gavinmcc/esp8266-fan-remote/SPEC.md

# Protocol Specifications

Two fans are supported. Both use 13-pulse position-encoded OOK frames through the same CC1101.
The CC1101 frequency is switched per-command; PLL re-calibrates on SFSTXON.

---

# Fan 1 — Bedroom: RHINE UC7070T

## RF Parameters

| Parameter | Value |
|---|---|
| Frequency | 303.92 MHz  |
| Modulation  | OOK / ASK |
| Encoding | Position-encoded symbol pairs |

## Symbol Alphabet

Two pulse widths for each phase:

| Name | Phase | Width (µs) | Measured range |
|---|---|---|---|
| SHORT_H | HIGH  | ~250 | 195–296 µs |
| LONG_H  | HIGH  | ~550 | 400–662 µs |
| SHORT_L | LOW | ~450 | 294–499 µs |
| LONG_L  | LOW | ~790 | 743–848 µs |
| GAP | LOW | ~8000 | inter-rep gap  |

Each pulse is a (HIGH, LOW) pair. Symbol names use two letters: first = HIGH class, second = LOW class.

| Symbol | HIGH phase | LOW phase |
|---|---|---|
| LS | LONG_H | SHORT_L  |
| LL | LONG_H | LONG_L |
| SL | SHORT_H | LONG_L |
| SS | SHORT_H | SHORT_L  |

## Packet Structure

Each button press transmits **4 repetitions** of the following 13-pulse frame, each followed by an 8 ms gap:

```
[Header: 6 pulses] [Data: 7 pulses] [GAP 8ms]   × 4
```

### Header (6 pulses, fixed for all commands)

```
LS  LS  LL  SL  SS  LL
```

### Data Section (7 pulses, command-dependent)

The command is encoded by **N** — the position (0-indexed) of the `SS` symbol within the 7-pulse data section:

```
SL × N,  SS,  (tail)
```

**Tail when N < 5:**
```
LL,  SL × (4−N),  SHORT_H (terminal pulse before gap)
```

**Tail when N = 5:**
```
LONG_H (terminal pulse before gap)
```

All 5 valid N values produce identical total bit counts per rep (838 bits at 40 kbaud).

### Command Map

| Button | N | Data section (7 pulses) |
|---|---|---|
| HI | 0 | SS LL SL SL SL SL S_term |
| MED | 1 | SL SS LL SL SL SL S_term |
| LOW | 2 | SL SL SS LL SL SL S_term |
| OFF | 4 | SL SL SL SL SS LL S_term |
| LIGHT  | 5 | SL SL SL SL SL SS L_term |

N=3 not observed (may be unused or reserved).

## Capture Evidence

Re-captured with a dedicated second ESP8266+CC1101 RX unit. Each button pressed
individually; N value decoded from multiple clean 13-pulse frames per button.

| Button | N decoded | Notes |
|---|---|---|
| HI | 0 | SS at data[0], LL+SL×4 tail |
| MED | 1 | SS at data[1], LL+SL×3 tail |
| LOW | 2 | SS at data[2], LL+SL×2 tail |
| OFF | 4 | SS at data[4], LL+SL×0 tail |
| LIGHT  | 5 | SS at data[5], LONG_H tail |

Earlier 12-capture set (physical remote captured without dedicated RX unit) had
HI/MED swapped and LOW/LIGHT swapped in the label column — the N decoding logic
was correct but the buttons were mislabelled. OFF (N=4) was correct in both sets.

## Hardware

- **CC1101 module**: E07-M1010 (Ebyte/CDEBYTE) — 300–348 MHz, 10 dBm max TX
- **MCU**: ESP8266 (Generic / Wemos D1 Mini)

## CC1101 Configuration

TX uses CC1101 FIFO mode. The OOK pulse pattern is pre-computed as an NRZ byte stream at 40 kbaud (25 µs/bit) and streamed through the CC1101 TX FIFO.

| Register | Value | Purpose |
|---|---|---|
| PKTCTRL0 | `0x02` | FIFO mode, infinite packet length, no CRC, no whitening |
| MDMCFG2 | `0x30` | OOK modulation, no sync word |
| FREND0 | `0x11` | OOK=1 uses PATABLE[1] (carrier on); OOK=0 = PATABLE[0] (PA off) |
| DRATE | 40 kbaud | via `setDRate(40)` |
| PATABLE[0] | `0x00` | OOK=0 state — PA off (carrier silence) |
| PATABLE[1] | `0xC0` | OOK=1 state — ~10 dBm TX power |

**Critical PATABLE note:** `PATABLE[0]` must be `0x00`, not the library default `0xC0`.
If all 8 PATABLE entries are `0xC0`, OOK=0 still drives full carrier and no modulation
reaches the fan. The firmware writes this explicitly after library init:

```cpp
ELECHOUSE_cc1101.SpiWriteReg(REG_FREND0, 0x11);
byte pa[8]; memset(pa, 0x00, sizeof(pa)); pa[1] = 0xC0;
ELECHOUSE_cc1101.SpiWriteBurstReg(REG_PATABLE, pa, 8);
```

## FIFO Encoding (40 kbaud NRZ)

At 40 kbaud, 1 bit = 25 µs. Each OOK pulse phase is a run of 1-bits (carrier on) or 0-bits (carrier off).

| Symbol  | ON bits | OFF bits | Actual µs  | Target µs |
|---|---|---|---|---|
| SHORT_H | 10 | — | 250 | ~250 |
| LONG_H  | 22 | — | 550 | ~550 |
| SHORT_L | — | 18 | 450 | ~450 |
| LONG_L  | — | 32 | 800 | ~790 |
| GAP | — | 320 | 8000 | ~8000 |

Each rep is 838 bits. The firmware sends more reps than the original remote to improve reliability:

| Command | REPS | Total bits | Duration |
|---|---|---|---|
| HI | 25 | 20,950 | ~525 ms |
| MED | 25 | 20,950 | ~525 ms |
| LOW | 25 | 20,950 | ~525 ms |
| OFF | 50 | 41,900 | ~1050 ms |
| LIGHT | 10 | 8,380 | ~210 ms |

OFF uses more reps for reliability. LIGHT was originally set to 4 reps on the assumption
that more would trigger the dimmer, but 10 reps works reliably without dimming on the
tested unit. The dimmer threshold may be higher than initially estimated, or unit-dependent.

## TX Sequence

1. `buildStream(N)` — pre-compute NRZ byte stream into `g_stream[]`
2. `SFSTXON` strobe — PLL calibrates and locks (~800 µs), PA stays off (FSTXON state)
3. Write first 64 bytes into TX FIFO
4. `STX` strobe — PA on, transmission starts instantly (PLL already locked)
5. Polling loop — read TXBYTES, top up FIFO in chunks until all bytes sent
6. Wait for `TXFIFO_UNDERFLOW` flag (last byte transmitted)
7. `SIDLE` + `SFTX` — return to idle and clear underflow flag

## Capture Methodology

Raw pulses captured using `capture/capture.ino`:
- CC1101 in OOK RX mode at 303.92 MHz, 812.5 kHz RX bandwidth
- GDO0 pin configured as demodulated digital data output
- Records HIGH/LOW durations until gap > 8 ms (end of rep)
- Prints raw `+HHH-LLL` tokens over Serial

## Current Status

**Fully working** as of 2026-08-10. All five commands (HI/MED/LOW/OFF/LIGHT) control the fan
reliably at 3 m. LIGHT toggles in both directions (ON→OFF and OFF→ON).

Range improved from ~1.2 m (earlier strobe approach) to 3 m after switching to FIFO mode —
the PA stays continuously warm throughout the burst rather than cold-starting per pulse.

Alexa voice control works via Espalexa (see README for setup and required library patch).

## Investigation History

| Approach | Outcome |
|---|---|
| 73-bit byte-based protocol (original analysis) | Wrong — reanalysis shows 13-pulse position-encoded protocol |
| Async GDO0 bit-bang (PKTCTRL0=0x32) | CC1101 enters TX state but GDO0 does not modulate OOK |
| FIFO mode (PKTCTRL0=0x02) | TXBYTES drains cleanly, no underflows |
| FREND0=0x10 (manual fix attempt) | Wrong — OOK=1 still used PATABLE[0]=0x00 → no carrier |
| FREND0=0x11 + PATABLE all 0xC0 | OOK=0 drove full carrier — gating still broken |
| FREND0=0x11 + PATABLE[0]=0x00, [1]=0xC0 | Correct — OOK properly gates carrier on/off |
| MDMCFG2=0x20 (reserved modulation) | Emits carrier but no OOK gating — fixed with 0x30 |
| First CC1101 unit (E07-M1010) | Suspected hardware defect — replaced with E07-M1101D |

---

# Fan 2 — Girls: SMC-5060-RF

## RF Parameters

| Parameter | Value |
|---|---|
| Frequency | 433.92 MHz  |
| Modulation  | OOK / ASK |
| Encoding | Position-encoded symbol pairs (same scheme as Fan 1, different N values) |

## Symbol Alphabet

| Name | Phase | Width (µs) | Measured range | Bits at 40 kbaud |
|---|---|---|---|---|
| SHORT_H | HIGH  | ~225 | 188–349 µs | 9 |
| LONG_H  | HIGH  | ~425 | 405–452 µs | 17 |
| SHORT_L | LOW | ~250 | 158–280 µs | 10 |
| LONG_L  | LOW | ~475 | 398–496 µs | 19 |
| GAP | LOW | ~7750 | inter-rep gap  | 310 |

## Packet Structure

Each button press transmits **20 repetitions** (4 for LIGHT) of the following 13-pulse frame,
each followed by a ~7750 µs gap:

```
SL×N + SS + LL + SL×(7-N) + SS + LL + SS + L_term + GAP   × REPS
```

Total SLs per frame always equals 7. Total pulses always equals 13.

### Command Map

| Button | N | Frame (before first gap) |
|---|---|---|
| HI | 4 | `SL SL SL SL SS LL SL SL SL SS LL SS L` |
| MED | 3 | `SL SL SL SS LL SL SL SL SL SS LL SS L` |
| LOW | 0 | `SS LL SL SL SL SL SL SL SL SS LL SS L` |
| OFF | 5 | `SL SL SL SL SL SS LL SL SL SS LL SS L` |
| LIGHT  | 1 | `SL SS LL SL SL SL SL SL SL SS LL SS L` |

N=2 and N=6 are not used.

## Address Encoding

DIP switch setting (physical remote, switches 1–4): **OFF ON OFF ON**

The DIP switch address is implicitly encoded in the N-value mapping: changing the
DIP switch changes which N value the remote sends for each command. The receiver
responds only to the N values that match its programmed DIP setting. No explicit
address field appears in the 13-pulse frame.

Comparing Fan 1 (UC7070T) and Fan 2 (SMC-5060-RF):

| Command | Fan 1 N | Fan 2 N |
|---|---|---|
| HI | 0 | 4 |
| MED | 1 | 3 |
| LOW | 2 | 0 |
| OFF | 4 | 5 |
| LIGHT | 5 | 1 |

## Capture Methodology

Captured using `capture/capture.ino` temporarily reflashed to 433.92 MHz.
Each button pressed individually; N decoded from multiple clean 13-pulse frames.

| Button | N decoded | Capture frames used |
|---|---|---|
| HI | 4 | #26–28 (prev session) |
| MED | 3 | #36–40 |
| LOW | 0 | #41–45 |
| OFF | 5 | #47–51 |
| LIGHT  | 1 | #52–56, #57 |

## Current Status

**Firmware added** 2026-08-11. Awaiting first hardware test.
