gavinmcc/esp8266-fan-remote/c1101_pinout.jpeg

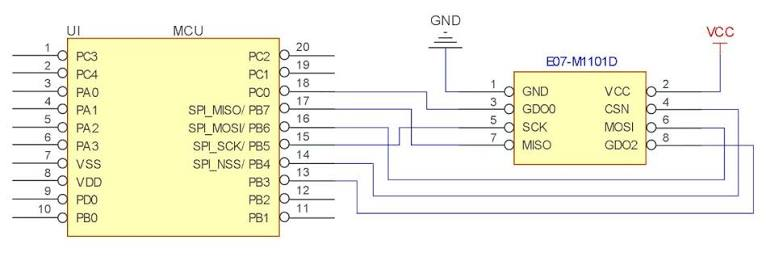
c1101_pinout.jpeg
