gavinmcc/esp8266-fan-remote/rf_debug.html

# RF Protocol Debug — UC7070T Ceiling Fan

Systematic comparison: physical remote vs ESP8266 + CC1101 firmware

Freq: 303.92 MHz

Mod: OOK / ASK

Rate: ~40 kbaud

10 parameters confirmed matching

2 bugs found & fixed (unverified in field)

3 parameters unknown / unverified

1 dimension differs (rep count)

CC1101 Registers

Register | Addr | Required value | What firmware sets | Status | Notes
MDMCFG2 | 0x12 | 0x30 — OOK, no sync | 0x30 ← was 0x20 | FIXED | 0x20 = bits 6:4=010 = reserved modulation. CC1101 emits RF but FIFO data doesn't gate the PA → no OOK. Never verified in field after fix.
FREND0 | 0x22 | 0x10 — PA = PATABLE[0] | 0x10 ← library wrote 0x11 | FIXED | Library's setModulation(2) writes bits 2:0=001 → OOK='1' uses PATABLE[1]=0x00 (silent). 0x10 routes to PATABLE[0]=0xC0.
PKTCTRL0 | 0x08 | 0x02 — FIFO, infinite, no CRC | 0x02 | ✓ OK | Confirmed in startup log.
PATABLE[0–7] | 0x3E | all 0xC0 (~10 dBm) | all 0xC0 | ✓ OK | Burst-written. PATABLE[0] confirmed via startup readback.
MDMCFG1 | 0x13 | NUM_PREAMBLE=0 or irrelevant | library default | ? UNKNOWN | SYNC_MODE=0 (from 0x30) should suppress preamble in TX. Default NUM_PREAMBLE=4 bytes. Not explicitly verified.
MDMCFG2 readback | 0x12 | 0x30 | unconfirmed | ? UNVERIFIED | User's last serial log truncated before register check lines. Cannot confirm 0x30 fix was actually in the flashed binary.

Pulse Timing (40 kbaud → 1 bit = 25 µs)

Symbol | Physical remote — measured range | Physical remote — avg | Firmware — bits × 25 µs | Firmware — µs | Δ | Status
Pulse 0 HIGH (SYNC0_H) | 400 – 451 µs | 421 µs | 17 bits | 425 µs | +4 µs | ✓ OK
Pulse 0 LOW (SYNC0_L) | 294 – 359 µs | 340 µs | 14 bits | 350 µs | +10 µs | ✓ OK
LONG_H (pulses 1+) | 522 – 662 µs | 598 µs | 24 bits | 600 µs | +2 µs | ✓ OK
SHORT_H | 195 – 296 µs | 243 µs | 10 bits | 250 µs | +7 µs | ✓ OK
SHORT_L (non-first) | 398 – 499 µs | 448 µs | 18 bits | 450 µs | +2 µs | ✓ OK
LONG_L | 740 – 848 µs | 795 µs | 32 bits | 800 µs | +5 µs | ✓ OK
GAP | ~8000 µs | 8000 µs | 320 bits | 8000 µs | 0 | ✓ OK
Data rate | ~40 kbaud (inferred) | — | setDRate(40) | ~40,000 bps | ≈ | ✓ OK

Frame Structure

Parameter | Physical remote | Firmware | Status | Notes
Header symbols | LS LS LL SL SS LL | LS LS LL SL SS LL | ✓ OK | Confirmed via 12 captures, consistent across all buttons.
Data encoding | N×SL, SS, tail | N×SL, SS, tail | ✓ OK | N = position of SS in 7-pulse data section.
Pulses per rep | 13 | 13 | ✓ OK
Bits per rep | ~838 bits (estimated) | 837 bits | ✓ OK | Calculated from measured timing; firmware total confirmed by FIFO byte count.
Repetitions per press | ~12 reps (captured) | 8 reps | ↓ LOW | Physical remote captured sending 12+ identical reps. Firmware sends 8. Fan may require more consecutive valid frames.
Inter-rep gap | ~8000 µs | 8000 µs | ✓ OK
Pre-stream preamble | none | none if SYNC_MODE=0 | ? ASSUMED | CC1101 docs say "no preamble if SYNC_MODE=0". MDMCFG2=0x30 sets SYNC_MODE=000. Assumed correct but not empirically verified.

Command Map (N values)

Command | N (physical remote) | N (firmware) | Capture evidence | Status
MED | 0 | 0 | Caps 3, 8 — consistent | ✓ OK
HI | 1 | 1 | Caps 2, 9 — consistent | ✓ OK
LIGHT | 2 | 2 | Caps 1, 10 — consistent | ✓ OK
— (unknown) | 3 | 3 (via /try?n=3) | Never captured. May be unused. | ? UNTESTED
OFF | 4 | 4 | Caps 5, 11 — consistent | ✓ OK
LOW | 5 | 5 | Caps 4, 6, 7, 12 — consistent | ✓ OK

Per-Rep Frame Layout (N=1, HI)

LS₀

0

LS

1

LL

2

SL

3

SS

4

LL

5

HEADER

SL

6

SS★

7

LL

8

SL

9

SL

10

SL

11

S_t

12

DATA

GAP

8ms

LS — Long High + Short Low

LL — Long High + Long Low

SL — Short High + Long Low

SS — Short High + Short Low (command marker)

GAP — 8ms silence

★ SS at pulse 7 = N=1 = HI. N is the zero-based data-section index of SS (pulse 6 = data[0], so SS at pulse 7 = data[1] = N=1).

Signal Characteristics (inferred / unverified)

Dimension | Physical remote | CC1101 firmware | Status | Notes
OOK PA gating | Crystal OSC, simple PA on/off | PLL + PA via PATABLE[0]/off | ? ASSUMED | With MDMCFG2=0x30, FIFO '1' should turn PA on (PATABLE[0]=0xC0), '0' should turn PA off. Not empirically verified. Carrier test only verifies RF emission, not modulation.
Signal polarity | HIGH = carrier on | bit='1' = carrier on | ✓ OK | GDO0 HIGH in RX = carrier detected = '1'. Our NRZ stream: 1-bits for HIGH phases, 0-bits for LOW. Consistent.
Carrier frequency | 303.9 MHz (FCC ID CHQ7070T) | 303.92 MHz | ✓ OK | Confirmed: carrier jams physical remote at ~2m from fan ceiling receiver.
TX power / range | unknown (~5–10 dBm typical) | ~10 dBm (0xC0) | ✓ OK | Carrier test confirmed jamming at ceiling fan range (~2–3m). Range not the limiting factor.
OOK '0' suppression | Clean — dedicated PA with fast off | unknown — CC1101 PA ramp | ? UNKNOWN | If CC1101 has slow PA turn-off, '0' bits might have residual carrier. Could confuse envelope detector. Use /carrier_ook test to verify.

Remaining Diagnostic Actions

1

Confirm MDMCFG2=0x30 via startup log

Flash, open Serial Monitor, look for: MDMCFG2=0x30 (expect 0x30). If it shows 0x20, the 0x30 fix was not compiled in. The last test log was truncated and this cannot be confirmed.

2

Verify OOK PA gating with /carrier_ook

Add endpoint that sends alternating 0xFF/0x00 blocks (half-on, half-off carrier). In true OOK mode the physical remote should work through the intermittent carrier. If the remote gets jammed just as strongly as with all-0xFF, the PA is not gating (OOK broken despite 0x30). This is the key test to verify modulation — not just RF emission.

3

Increase REPS from 8 → 15

Physical remote captures show ~12 repetitions per button press. Our firmware sends 8. Some receivers require a minimum run of consecutive valid frames before accepting a command. This is a free change: bump #define REPS 15.

4

Add /dumpregs to read back all CC1101 registers

Read MDMCFG2, MDMCFG1, MDMCFG4, MDMCFG3, FREND0, PKTCTRL0, PKTCTRL1, FSCTRL1, FSCTRL0, FREQ2/1/0, MCSM0/1, CHANNR and print them all. Compare against the CC1101 datasheet expected values for OOK at 303.92 MHz. Eliminates all register ambiguity in one shot.

5

Self-capture: transmit while capture sketch listens

Flash capture.ino on the same (or second) ESP8266, place it near the fan_remote ESP8266, trigger a command, and see if the capture sketch decodes the correct pulse pattern. This verifies the actual OOK signal being emitted. Requires two ESP8266+CC1101 pairs, or brief firmware swap.
