gavinmcc/esp8266-fan-remote/analyze.py

#!/usr/bin/env python3
"""
analyze.py

Decodes raw OOK pulse captures from the UC7070T ceiling fan remote
and identifies the bit pattern for each button.

Encoding: PWM OOK
  HIGH > 380us + SHORT low  -> bit 1
  HIGH < 380us + LONG  low  -> bit 0
Sync pulses: HIGH > 600us (skipped as framing)
"""

THRESHOLD = 380   # us: above = long/1, below = short/0
SYNC_US   = 600   # us: HIGH above this = sync pulse, not data

CAPTURES = {
    "HI":    "+163-711 +744-732 +750-710 +739-733 +486-258 +474-234 +516-242 +238-472 +262-481 +487-236 +503-238 +473-262 +488-228 +254-474 +257-474 +255-478 +251-477 +269-475 +261-454 +257-473 +269-469 +274-448 +494-260 +253-477 +479-225 +279-476 +253-476 +505-233 +500-227 +254-476 +481-237 +280-444 +268-472 +260-480 +269-464 +254-479 +272-444 +525-196 +285-443 +291-444 +510-239 +276-446 +494-228 +510-235 +497-240 +275-448 +492-228 +254-475 +520-238 +281-443 +498-230 +256-478 +257-475 +481-240 +280-447 +493-259 +254-474 +480-224 +281-474 +481-239 +512-230 +260-452 +516-236 +282-450 +473-262 +227-482 +481-270 +281-440 +269-442 +523-201 +312-432 +283-447 +270-478 +491-229 +252-472 +289-442 +288-508 +742-712 +769-693 +745-713 +766-734 +489-229 +511-236 +485-241 +277-440 +261-481 +487-238 +507-240 +474-229 +518-235 +244-469 +274-446 +296-461 +261-476 +257-471 +256-442 +285-476 +273-445 +262-456 +517-235 +278-440 +533-199 +267-460 +268-459 +530-219 +511-203 +273-473 +488-235 +281-470 +274-447 +265-456 +290-444 +256-471 +269-473 +502-230 +263-453 +292-442 +514-237 +245-480 +499-228 +481-234 +498-238 +281-447 +495-260 +253-477 +485-237 +281-444 +500-228 +256-481 +267-463 +480-274 +244-479 +490-227 +252-475 +515-193 +283-480 +509-200 +532-226 +254-446 +514-235 +279-451 +500-228 +288-450 +479-258 +252-475 +253-477 +509-236 +234-463 +293-445 +305-436 +479-237 +275-472 +261-478 +269-520 +723-737 +729-718 +751-710 +766-719 +486-236 +506-239 +477-229 +260-481 +291-445 +514-205 +517-237 +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
}

def parse_raw(raw):
    """Parse '+HHH-LLL' tokens into list of (high, low) tuples."""
    pulses = []
    for token in raw.strip().split():
        token = token.lstrip('+')
        if '-' in token:
            h, l = token.split('-')
            pulses.append((int(h), int(l)))
    return pulses

def extract_bits(pulses, threshold=THRESHOLD, sync_us=SYNC_US):
    """
    Strip sync pulses (HIGH >= sync_us) and decode data bits.
    Returns list of (block_index, bits) for each data block between syncs.
    """
    blocks = []
    current = []

    for hi, lo in pulses:
        if hi >= sync_us:
            # sync pulse — flush current block if it has data
            if len(current) >= 8:
                blocks.append(current)
            current = []
        else:
            current.append(1 if hi >= threshold else 0)

    if len(current) >= 8:
        blocks.append(current)

    return blocks

def bits_to_hex(bits):
    """Group bits into bytes and format as hex string."""
    result = []
    for i in range(0, len(bits) - 7, 8):
        byte = 0
        for b in bits[i:i+8]:
            byte = (byte << 1) | b
        result.append(f"{byte:02X}")
    remainder = len(bits) % 8
    if remainder:
        result.append(f"(+{remainder}bits)")
    return ' '.join(result)

def most_common_block(blocks):
    """Return the most common block (majority vote across repetitions)."""
    if not blocks:
        return []
    # Use the longest block as reference length
    ref_len = max(len(b) for b in blocks)
    # Majority vote bit by bit
    result = []
    for i in range(ref_len):
        ones = sum(1 for b in blocks if i < len(b) and b[i] == 1)
        result.append(1 if ones > len(blocks) / 2 else 0)
    return result

print("=" * 60)
print("UC7070T Ceiling Fan Remote — Protocol Analysis")
print("=" * 60)

decoded = {}
for name, raw in CAPTURES.items():
    pulses = parse_raw(raw)
    blocks = extract_bits(pulses)
    voted  = most_common_block(blocks)
    decoded[name] = voted
    print(f"\n{name}: {len(blocks)} repetitions, {len(voted)} bits each")
    print(f"  HEX: {bits_to_hex(voted)}")
    print(f"  BIN: {''.join(str(b) for b in voted)}")

# Find which bit positions differ between buttons
print("\n" + "=" * 60)
print("Bit differences between commands")
print("=" * 60)

names = list(decoded.keys())
ref_bits = decoded[names[0]]
ref_len  = len(ref_bits)

# Print aligned comparison
header = f"{'Bit':>4}  " + "  ".join(f"{n:>5}" for n in names) + "  SAME?"
print(header)
for i in range(ref_len):
    vals = [decoded[n][i] if i < len(decoded[n]) else '?' for n in names]
    same = len(set(vals)) == 1
    if not same:
        row = f"{i:>4}  " + "  ".join(f"{v:>5}" for v in vals) + "   <-- DIFFERS"
        print(row)

print("\nByte-level summary:")
print(f"{'Byte':>5}  " + "  ".join(f"{n:>5}" for n in names))
for byte_i in range(ref_len // 8):
    start = byte_i * 8
    rows = []
    for n in names:
        bits = decoded[n][start:start+8]
        val  = 0
        for b in bits:
            val = (val << 1) | b
        rows.append(f"  {val:02X}")
    same = len(set(rows)) == 1
    flag = "" if same else "  <-- DIFFERS"
    print(f"  B{byte_i}:  " + "".join(rows) + flag)
