gavinmcc/esp8266-fan-remote/(commit log)

2026-08-03 Initial commit: ESP8266 + CC1101 WiFi ceiling fan remote
    Captures OOK codes from RHINE UC7070T remote (DIP E7 80 29) and
    replays them via CC1101 E07-M1010 over HTTP endpoints.
    FIFO streaming mode implemented after async GDO0 bit-bang proved
    non-functional on this module. Awaiting replacement CC1101 to
    confirm RF emission before further debugging.
    [analyze.py, capture.ino, fan_remote.ino]
2026-08-03 Add README and protocol specification
    README covers hardware, wiring, dependencies, setup, and HTTP endpoints.
    SPEC documents the UC7070T OOK protocol, pulse timings, bit sequences,
    CC1101 register config, FIFO encoding scheme, and investigation history.
2026-08-09 Switch TX to SFSTXON-gating strobe mode; all 5 commands working at ~1m
    Replace FIFO streaming with SIDLE/STX strobe gating (MCSM0=0x00, IOCFG2=0x56).
    FIFO 0x00 bytes don't gate the E07-M1010 external PA — strobe gating via SIDLE
    is the only way to silence the carrier between OOK pulses on this module.
    Single PLL calibration at init (SFSTXON + 5ms), then SFSTXON issued at the end
    of each off-period so the PLL is pre-locked before the next STX strobe. This
    keeps timing jitter below 40µs even with cold ext-PA warm-up on SHORT_H bursts.
    REPS bumped 15→25→50: more repetitions give the fan's decoder more statistical
    chances to catch a valid frame despite the ext-PA cold-start degradation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
    [capture.ino, fan_remote.ino, test_esp8266_pins.ino]
2026-08-09 Add per-command REPS, fix async carrier mode, add /lighttry diagnostic endpoint
    Per-command rep counts:
    REPS_DEFAULT=25 (HI/MED/LOW), REPS_LIGHT=4 (short press ~84ms), REPS_OFF=50.
    LIGHT has a dimmer: burst >~130ms triggers hold/dim mode instead of toggle.
    LIGHT command is one-way ON; turning off requires a full dim-down hold.
    Fix PKTCTRL0: 0x62 was random TX mode (50% duty-cycle OOK noise), not async
    serial. 0x32 is the correct value for async serial mode where GDO0=HIGH gives
    a pure continuous carrier during TX, effectively doubling average burst power.
    Add /lighttry?reps=N endpoint (1-250 reps) for systematic probing of the
    toggle/hold boundary and minimum reliable reps at range.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
    [fan_remote.ino]
2026-08-10 Fix lwIP crash on long TX: send HTTP response before blocking operations
    Long /lighttry requests (150-200 reps, 3-4s) were corrupting the lwIP TCP
    stack because the HTTP connection stayed open during blocking TX. Fix: send
    the response before starting TX and add a 300ms TCP flush delay. Also add a
    50ms WiFi maintenance break every 32 reps (~670ms) to prevent watchdog issues.
    Light ON/OFF findings: N=5 short-press (5 reps, ~105ms) reliably turns light
    ON from OFF. Turning OFF requires the same signal but the fan is more demanding
    about signal quality in the ON state. The ext PA cold-start weakness (~200us
    warmup on 250us SHORT_H bursts) makes the ON->OFF direction unreliable at 1.2m.
    Long-ho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
    [fan_remote.ino]
2026-08-10 Add RF debug protocol comparison page
    HTML visualisation of UC7070T OOK frame structure used during protocol analysis.
2026-08-11 Fix FIFO OOK gating: PATABLE[0]=0x00, switch all handlers to FIFO mode
    Root cause of broken FIFO OOK gating: PATABLE[0] was 0xC0 (full power),
    but CC1101 uses PATABLE[0] for the OOK=0 (carrier-off) state. With all
    entries set to 0xC0, both on and off states produced identical carrier,
    making FIFO gating completely ineffective regardless of FIFO data.
    Fix: PATABLE[0]=0x00 (PA off for OOK=0), PATABLE[1]=0xC0 (full power
    for OOK=1), FREND0=0x11 (PA_POWER=1, so OOK=1 selects PATABLE[1]).
    With gating working, switch all fan command handlers from sendCommandStrobe
    (SIDLE/STX per-pulse) to sendCommand (continuous FIFO stream). The cleaner
    single-carrier burst now lets the fan decode LIGHT toggle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
    [capture.ino, fan_remote.ino]
2026-08-11 Add Alexa control via Espalexa (Hue bridge emulation)
    Exposes five devices discoverable by Alexa on the local network:
    "Bedroom Fan High/Medium/Low/Off" and "Bedroom Light"
    Uses the Espalexa library with an onNotFound handler forwarding
    unrecognised URIs to espalexa.handleAlexaApiCall(). espalexa.begin(&server)
    replaces server.begin() so both the existing web UI and Alexa discovery
    share port 80.
    Fix for Alexa only discovering the first device (espalexa issue #231):
    modify Espalexa.h encodeLightId() to use format
    "%02X:%02X:%02X:%02X:%02X:%02X-%02X-00:11"
    instead of the default "%02X:%02X:%02X:%02X:%02X:%02X:00:11-%02X".
    The reordered unique ID suffix causes Alexa to treat each device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
    [fan_remote.ino]
2026-08-11 Update README and SPEC with Alexa setup, FIFO mode details, and correct CC1101 config
    README: Rewrote wiring diagram to show CC1101 2x4 pin grid, added Alexa device
    table with device names, added required Espalexa.h patch instructions and link
    to issue #231, added PATABLE gating explanation.
    SPEC: Updated CC1101 config table to show correct PATABLE[0]=0x00/[1]=0xC0/
    FREND0=0x11 setup with code snippet explaining the fix. Added per-command REPS
    table. Updated Current Status to reflect fully working state and Alexa
    integration. Expanded investigation history with all resolved dead-ends.
2026-08-11 Prune ~600 lines of investigation dead code from fan_remote.ino
    Remove strobe-based TX (sendCommandStrobe, strobeBit, fastStrobe),
    async GDO0 bit-bang (sendCommandAsync, asmBit), and all diagnostic
    endpoints that were only needed during protocol investigation:
    /carrier_ook, /carrier2, /asyncgate, /ooktest, /strobe_test,
    /marctest, /try, /lighttry.
    Keep: sendCommand (FIFO NRZ), cc1101InitTx, /carrier, /fifogate,
    /status, /dumpregs, all fan/light/Alexa handlers.
    Also fix g_stream buffer: REPS_OFF=50 needs ~5250 bytes; was 1600.
    [fan_remote.ino]
2026-08-11 Add device testing photo to README
2026-08-11 Add caption to device testing photo
2026-08-11 Add note about DIP switch address hard-coding in README
2026-08-11 Fix IOCFG label and remove unused struct fields in handleDumpregs
    IOCFG0 at 0x00 was wrong — CC1101 0x00 is IOCFG2.
    Drop unused `expect` and `status` fields from the regs[] struct.
    [fan_remote.ino]
2026-08-12 Add end-to-end test script (test_e2e.py)
    Verifies CC1101 register state via /status, sends all five fan commands
    and checks HTTP responses, and confirms RF was transmitted by reading
    RSSI and pulse captures from the RX unit's serial port.
    Auto-detects the RX serial port by looking for [RSSI] output.
    Exits 0 on all-pass, 1 on any failure.
    [test_e2e.py]
2026-08-12 Add Girls fan (SMC-5060-RF, 433.92 MHz) support
    Decoded the SMC-5060-RF protocol from raw captures:
    - Same 13-pulse position-encoding scheme as UC7070T
    - Different N values per command (address is implicit in N mapping)
    - Shorter pulse widths (~225/425µs vs ~250/600µs) and shorter gap (~7750µs)
    - Runs at 433.92 MHz; CC1101 frequency switches per-command
    N values: HI=4, MED=3, LOW=0, OFF=5, LIGHT=1
    Timing: SHORT_H=9, LONG_H=17, SHORT_L=10, LONG_L=19, GAP=310 (bits at 40kbaud)
    Adds /girls/* HTTP endpoints, Girls Fan * Alexa devices (10 total),
    dual-fan web UI, and SPEC.md section for the new fan.
    Also reverts capture/capture.ino back to 303.92 MHz (was temporarily
    set to 433.92 MHz for S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
    [capture.ino, fan_remote.ino]
2026-08-12 Rename bedroom endpoints to /bedroom/* for consistency with /girls/*
    All fan commands now use /bedroom/hi, /bedroom/med, etc.
    Web UI, test_e2e.py, and README updated to match.
2026-08-12 Document Girls fan DIP switch address: OFF ON OFF ON (switches 1-4)
2026-08-12 Make firmware data-driven: device config lives in devices.json
    - devices.json: all per-fan parameters (timing, N-values, reps, Alexa
    names, protocol type, frequency) in one human-editable file
    - gen_config.py: reads devices.json, emits fan_remote/fan_config.h with
    structs, FANS[] array, and static Alexa callback thunks
    - build.sh: runs gen_config.py then compiles and uploads in one step
    - fan_remote.ino: hardcoded B_*/G_* constants removed; HTTP routes and
    Alexa devices registered in a loop over FANS[]; two protocol frame
    builders (UC7070T, SMC5060RF) parameterised by FanDevice timing struct
    - capture.ino: accepts "FREQ <mhz>" serial command to retune RX frequency
    at runtime withou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
2026-08-12 Add E2E test sample output to README
    Documents a real test run (10/11 pass) with a note explaining the GIR:LOW
    RF miss — marginal 433 MHz sensitivity on the out-of-band E07-M1010 capture
    module; resolved by touching antennas.
2026-08-12 Update E2E sample output to fully passing run (11/11)
2026-08-12 Validate RF protocol in e2e test: decode N value from captured frames
    parse_pulses() extracts (hi_us, lo_us) pairs from capture unit output.
    decode_N() classifies each pulse pair using midpoint thresholds derived
    from devices.json timing, then counts SL pulses before the first SS —
    skipping the 6-pulse header for UC7070T, scanning from pulse 0 for
    SMC5060RF.
    If captured frames are available the decoded N is checked against the
    expected N in devices.json and reported per command:
    PASS BED:HI HTTP=ok RF=captured 16 frame(s) N=0 ✓
    FAIL BED:HI HTTP=ok RF=captured 16 frame(s) N=2 (expected 0) ✗
    [test_e2e.py]
2026-08-12 Fix protocol decode: correct thresholds and alignment robustness
    devices.json: add hi_thresh_us / lo_thresh_us to each device's timing.
    These are midpoints of the measured gap between SHORT and LONG pulse
    widths (from SPEC.md). The old midpoint-of-nominal formula placed the
    UC7070T HIGH threshold at 425 us (inside the LONG_H measured range
    400-662 us) and the SMC5060RF HIGH threshold at 325 us (inside the
    SHORT_H measured range 188-349 us), causing misclassification.
    New values: UC7070T 350/620 us, SMC5060RF 380/340 us.
    decode_N in test_e2e.py:
    UC7070T: replaced fixed 'skip 6 pulses' with a scan for the header's
    'SL SS LL' tail pattern. This anchors the data section regardle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
    [test_e2e.py]
2026-08-12 Fix SMC5060RF protocol decode for out-of-band capture
    The E07-M1010 receiver (rated 300-348 MHz) running at 433 MHz causes two
    systematic distortions:
    1. The inter-rep gap (~7750µs) is compressed to ~3000µs, below the capture
    unit's 8000µs threshold, so the previous rep's last pulse is captured
    with the gap as its lo. Fix: skip leading pulses where lo > 1000µs.
    2. AGC settling stretches the hi of the first real pulse per rep (e.g. a
    225µs SHORT_H measures as 466µs, classifying as LONG_H). Fix: use lo-only
    classification for the first real pulse, since lo is unaffected.
    Subsequent pulses are clean. Treat LL same as SL in the data-counting phase
    for robustness against occa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
    [test_e2e.py]
2026-08-13 Split config into model_database.json + devices.json
    model_database.json holds protocol/timing/default commands per fan model,
    keyed by model_id. devices.json holds the user's specific devices — just
    name, path, Alexa names, model reference, and any DIP-switch N overrides.
    gen_config.py and test_e2e.py both merge the two files at load time,
    producing the same flat structure downstream so no other code changes.
    The split makes it easy to add support for a new model by adding one entry
    to model_database.json and a short devices.json entry referencing it.
    [gen_config.py, test_e2e.py]
2026-08-13 Move devices.json to devices.json.example; ignore local copy
    Same pattern as secrets.h — copy devices.json.example to devices.json
    and customise for your installation. devices.json is gitignored so
    per-install config stays local.
2026-08-13 Document two-file config structure in README
    Explains model_database.json (shared, per-model) vs devices.json (local,
    gitignored), with example entries for fixed-N and DIP-addressed models.
    Updates Setup steps to include the devices.json copy step.
2026-08-13 Highlight Hampton Bay / Harbor Breeze compatibility in README
    Makes the UC7070T's reach explicit — it covers the Hampton Bay and
    Harbor Breeze lines sold at Home Depot and Lowe's, which are among
    the most common ceiling fans in North America.
2026-08-16 Queue Alexa commands to respond before transmitting RF
    Alexa has a short response timeout. Previously dispatchAlexa() called
    sendCommand() synchronously, blocking inside espalexa.loop() for up to
    ~1s (50-rep OFF command) before the HTTP response could go out. Alexa
    would time out and report failure even though the fan received the command.
    Fix: dispatchAlexa() now writes to a one-slot pending queue and returns
    immediately. loop() drains the queue at its next iteration, after
    espalexa.loop() has sent the response. HTTP path was already correct
    (server.send() before sendCommand()).
    [fan_remote.ino]
2026-08-17 Debounce Alexa dispatch; increase SMC5060RF light reps to 10
    Alexa sends paired on+off events for a single voice command, causing
    toggle commands to double-fire now that dispatchAlexa() returns
    immediately. Fix: ignore repeats of the same Alexa slot within 2 seconds.
    With the debounce in place the double-toggle risk is gone, so SMC5060RF
    light reps can be raised from 4 to 10 for better reliability, matching
    the UC7070T.
    [fan_remote.ino]
